nunosousa/casal-k181/docs/project/constraints.md

# Project constraints

The following are hard boundaries within which the project operates. They
are architectural in nature — accepting or violating any of them changes
what the project *is*.

## Engine architecture

- **Carburettor baseline, optional throttle-body fuel injection.** Initial
  running and ignition development retain a carburettor. Later exploration
  may replace it with a throttle body and electronically controlled
  injector, using sensors and ECU calibration to control fuel delivery
  (see [ADR-0010](decisions/0010-throttle-body-fuel-injection.md)).
- **No reed-valve conversion.** Piston-port induction retained.
- **No cylinder porting modifications.** Port geometry as delivered by the
  Eurocilindro kit is accepted as-is. Head, squish geometry, ignition,
  exhaust, gearing and instrumentation are open for optimisation.
- **Original two-stroke architecture.** The engine remains recognisably a
  Casal M151-derived two-stroke, not a fundamentally different racing
  engine.

## Road-legal compliance

- **Exterior lamps must be incandescent.** LED lamps in the stock K181
  exterior lamp housings (headlight, tail, brake, front and rear
  indicators) are not road-legal in Portugal because the housings'
  reflector and lens optics are designed around incandescent-filament
  emitters; LED retrofit disturbs the certified photometric properties.
  See [ADR-0005](decisions/0005-retain-incandescent-exterior-lamps.md).
- **Horn: non-LED.** Same rationale; also unrelated to LED question but
  covered by the same "original technology in stock housings" principle.
- Dashboard interior illumination (behind dial faces) and warning-lamp
  cluster (visible only to the rider) are unaffected — LED remains
  acceptable there.
- **Daytime headlight** required for two-wheelers under Portuguese law.
  Bounds load-shedding policy (the headlight cannot be shed).

## Character preservation

- The finished vehicle must remain visually and mechanically recognisable
  as a Casal K181.
- Instrumentation and modernised electronics must not be visually
  obtrusive. No probes hanging out of the exhaust, no zip-tied harnesses,
  no visible aftermarket displays. Service access hidden under panels.
- Original dial faces (or credible reproductions) preferred on dashboard
  gauges, driven by modern electronics behind the panel.
- Speedometer/odometer, tachometer and warning lamps retain separate
  stock-style enclosures, each containing its own CAN controller. No
  central handlebar controller; remaining dashboard/handlebar functions
  belong to the warning-cluster unit per
  [ADR-0012](decisions/0012-distributed-dashboard-can-nodes.md).

## Committed hardware

- **Eurocilindro NOS 44 mm bore kit** — ~60 cc, adopted as the top-end.
- **NOS 5-speed gearbox** — adopted as the transmission.
- **Original carburettor retained for the first running baseline.**
  Carburettor optimisation precedes any fuel-injection experiment. Mechanical
  points are skipped; first engine run is with ECU-controlled fixed-timing
  ignition (see [staged plan](staged-plan.md)).

## Intended use

- Occasional Sunday riding. Not a race vehicle, not a pure test rig.
- Must survive rain, vibration, seasonal thermal cycling, and being
  ignored for months. This drives IP-rated enclosures, sealed connectors,
  conformal coating, and non-consumer-grade internal storage.
- Must never leave the rider stranded due to a soft failure in the ECU.
  Boot into a safe fixed-timing map on any config-store or map fault.
  Any injected configuration must also have a validated fuel-calibration
  fallback; fixed ignition timing alone cannot recover lost fuel control.

## Process

- Hobby project. No certified-automotive or aerospace process burden.
- Use the [lightweight engineering framework](engineering.md) for identified
  requirements, interface control, hazard review and verification evidence
  (see [ADR-0011](decisions/0011-lightweight-engineering-documentation.md)).
  Documentation discipline does not introduce certification obligations.
- One variable at a time, wherever possible. Every subsystem change is
  characterised against a preserved baseline dataset.
- All architectural decisions of consequence recorded as ADRs under
  `docs/project/decisions/`.
