nunosousa/casal-k181/cad/frame-reference/brake-lever-perch.FCStd

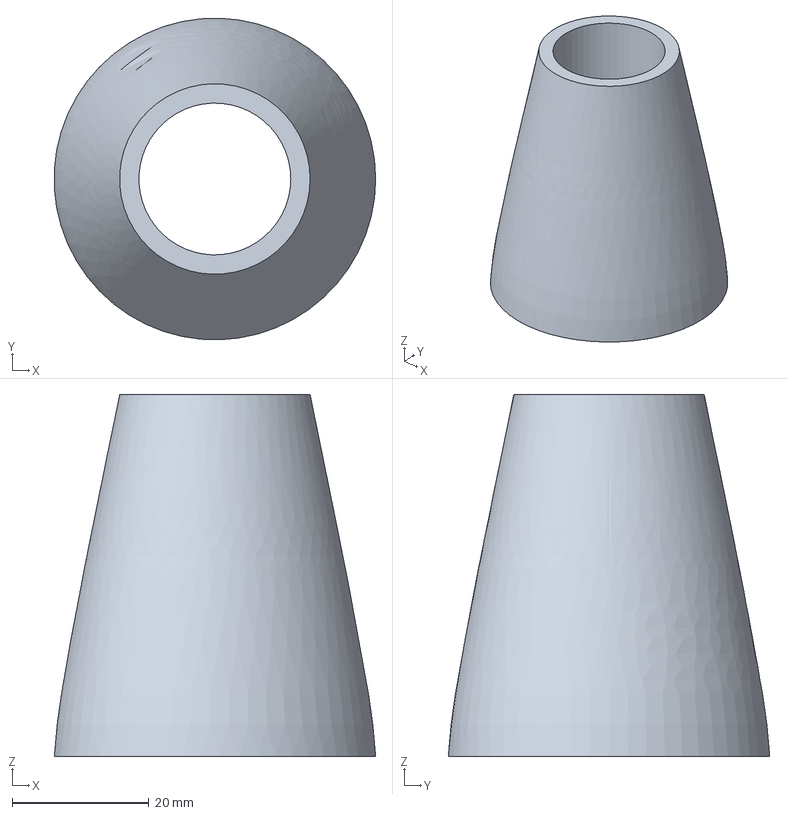
[picture p1: CAD file, 2026-11-06]
cad/frame-reference/brake-lever-perch.FCStd
46.9 x 46.9 x 52.9 mm
