nunosousa/casal-k181/cad/frame-reference/engine-mount-left.FCStd

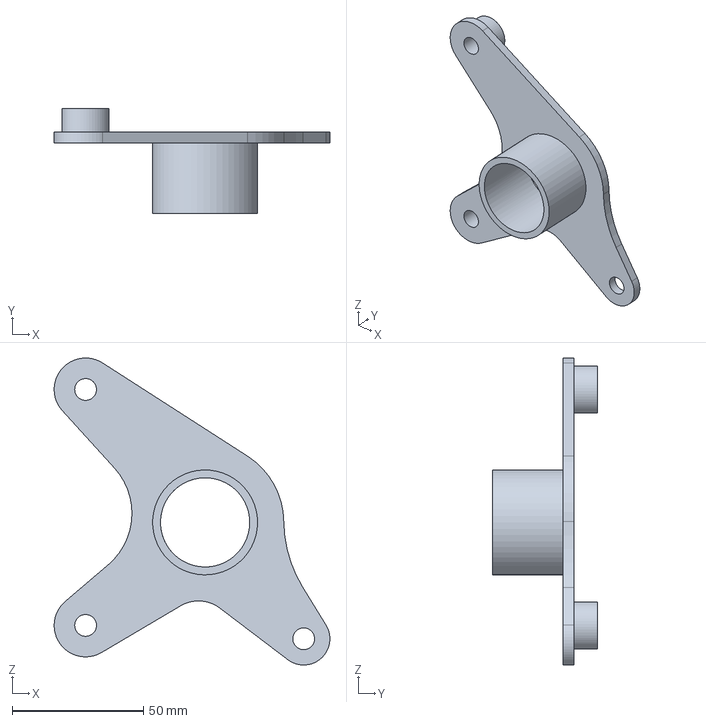
[picture p2: CAD file, 2026-11-04]
cad/frame-reference/engine-mount-left.FCStd
105.1 x 40.0 x 117.0 mm
