nunosousa/casal-k181/cad/frame-reference/engine-mount-right.FCStd

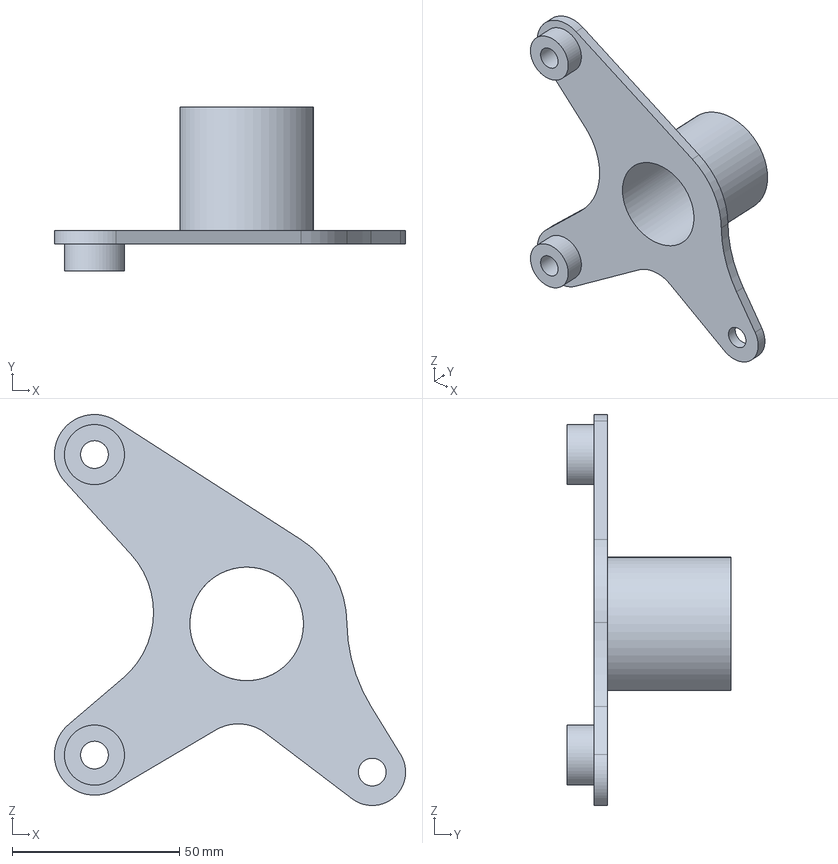
[picture p3: CAD file, 2026-11-04]
cad/frame-reference/engine-mount-right.FCStd
105.1 x 49.0 x 117.0 mm
