nunosousa/casal-k181/cad/frame-reference/frame.FCStd

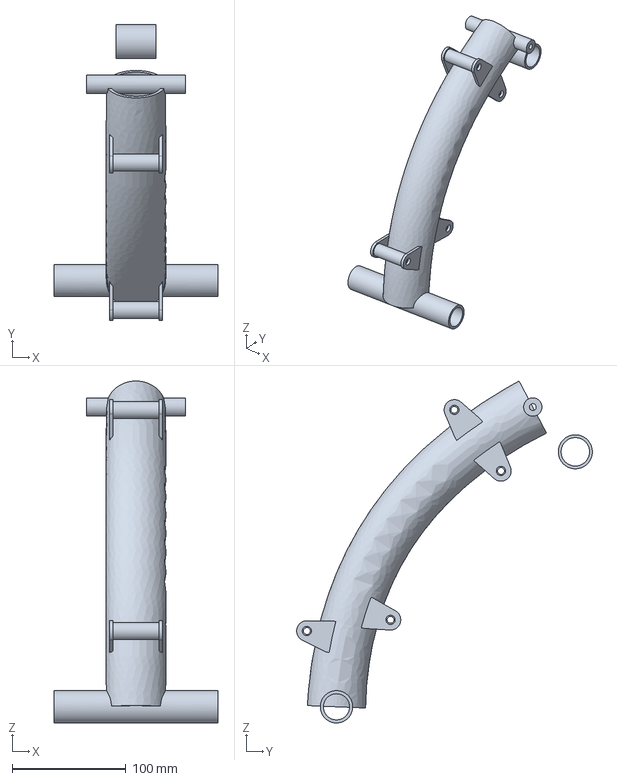
[picture p4: CAD file, 2026-11-02]
cad/frame-reference/frame.FCStd
144.0 x 260.1 x 300.8 mm
