nunosousa/casal-k181/cad/frame-reference/front-suspension-bushing.FCStd

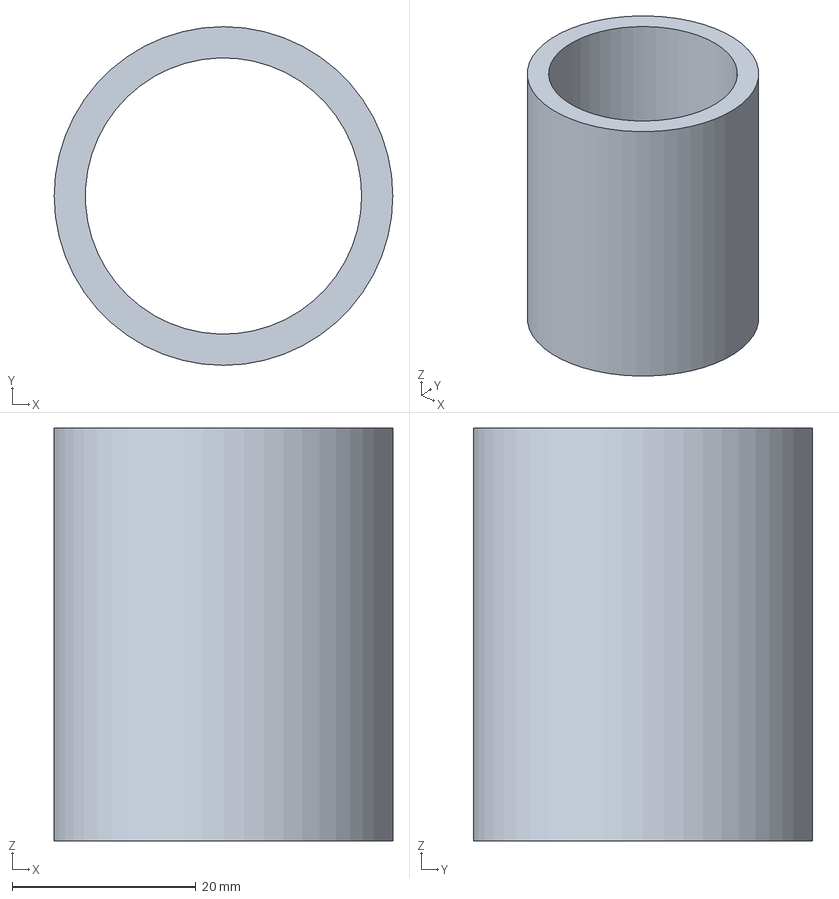
[picture p5: CAD file, 2026-11-02]
cad/frame-reference/front-suspension-bushing.FCStd
36.9 x 36.9 x 45.0 mm
