nunosousa/casal-k181/(list of files, cad)

Other CAD files:
cad/frame-reference/front-brake-lever.FCStd
cad/frame-reference/clutch-lever-perch.FCStd
cad/frame-reference/clutch-lever.FCStd
