nunosousa/casal-k181/(commit log)

2026-10-27 Add preliminary documentation for project requirements, hazards, and verification
    - Created a preliminary hazard register to outline potential hazards and proposed controls.
    - Established a system and allocated software requirements specification, detailing system behavior and acceptance criteria.
    - Documented the system concept description, outlining intended use, objectives, and operational modes.
    - Developed a requirements traceability matrix to link objectives, requirements, and verification states.
    - Introduced a verification and validation plan to define verification methods and procedures.
    - Added Python scripts for testing protocol messages and traceability matrix generation.
    - Inclu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
2026-11-02 Add frame and suspension reference models
    Add FreeCAD documents for the frame and front suspension bushing.
2026-11-02 Add initial CAD models documentation for Casal K181 project
2026-11-04 Updated engine mount parts.
